Lecostarius/wemos_lolin_airquality_monitor/(commit log)

2020-10-03 Integrated all sensors, seems to run fine.
2020-10-10 greatly improved version. Support for calibration.
